kbakobu4/The-generator-of-electrical-signals-of-various-forms-on-STM8/README.md

This project was developed for the STM8S207RB controller development board, which is a microcontroller with the necessary wiring, a 12-bit SPI dac7512n/3k DAC, a matrix keyboard and a MT-12864J graphic display.
