kbakobu4/The-generator-of-electrical-signals-of-various-forms-on-STM8/Перечень элементов курсача MCU.PDF

Изм. Лист | | | Подпись | Дата
| | Разраб. | Кушков Е.О. | | | Генератор электрических сигналов разной формы Перечень элементов | Литера | Лист | Листов
Пров. | Мусоров И.С. | | | | У | | | | 1

Копировал

| Микросхемы
DD1 | STM8S207RB микроконтроллер 8-бит, 24 МГц, | 1
| 128КБ Flash, 10-бит АЦП, USB, I2C, SPI [LQFP-48]
DD2 | DAC7512N/3K ЦАП 12-бит, SPI | 1
С1…C4 | GRM21BR71E104KA01L конденсатор керамический | 4
| 100 нФ
C5 | GRM319R71E684KA01D конденсатор керамический | 1
| 680 нФ
| Конденсаторы Подп. и дата

Поз.
Обознач.
Наименование | Кол. | Примечание.

Кнопки
| 17
X3 | № докум Взам. инв. № PLS-2 штыревой разъем 1x2 контакта

ТПУ ИШНКБ
группа 1А02

Н.контр
Утв. | Мусоров И.С.
Формат А4
X1 | PLS-4 штыревой разъем 1x4 контакта | 1
SB1…SB17 | IT-1187-160GM-G кнопка тактовая Подп. и дата ФЮРА.1А0212.012 ПЭ3 | 1
| | 1
X2 | PLS-20 штыревой разъем 1x20 контактов Инв. № дубл. Разъемы Инв. № подл
| Резисторы
R1…R5 | CF-100 (С1-4) 1 Вт, 1 кОм, 5% | 5
R6 | 3296W-1-103LF (СП5-2ВБ) 0,5 Вт, 10 кОм резистор | 1
| подстроечный
