kbakobu4/The-generator-of-electrical-signals-of-various-forms-on-STM8/ПЭ Курсач MCU.xlsx

Sheet: 1_Лист
 | Поз. Обознач. |  |  | Наименование |  |  |  | Кол. |  | Примечание.
 |  |  |  | Конденсаторы
 | С1…C4 |  |  | GRM21BR71E104KA01L конденсатор керамический |  |  |  | 4
 |  |  |  | 100 нФ
 | C5 |  |  | GRM319R71E684KA01D конденсатор керамический |  |  |  | 1
 |  |  |  | 680 нФ
 |  |  |  | Микросхемы
 | DD1 |  |  | STM8S207RB микроконтроллер 8-бит, 24 МГц, |  |  |  | 1
 |  |  |  | 128КБ Flash, 10-бит АЦП, USB, I2C, SPI [LQFP-48]
 | DD2 |  |  | DAC7512N/3K ЦАП 12-бит, SPI |  |  |  | 1
 |  |  |  | Резисторы
 | R1…R5 |  |  | CF-100 (С1-4) 1 Вт, 1 кОм, 5% |  |  |  | 5
 | R6 |  |  | 3296W-1-103LF (СП5-2ВБ) 0,5 Вт, 10 кОм резистор |  |  |  | 1
Подп. и дата
 |  |  |  | подстроечный
 |  |  |  | Кнопки
 | SB1…SB17 |  |  | IT-1187-160GM-G кнопка тактовая |  |  |  | 17
Инв. № дубл.
 |  |  |  | Разъемы
 | X1 |  |  | PLS-4 штыревой разъем 1x4 контакта |  |  |  | 1
 | X2 |  |  | PLS-20 штыревой разъем 1x20 контактов |  |  |  | 1
Взам. инв. №
 | X3 |  |  | PLS-2 штыревой разъем 1x2 контакта |  |  |  | 1
Подп. и дата
 |  |  |  |  |  |  | ФЮРА.1А0212.012 ПЭ3
 | Изм. | Лист | № докум |  | Подпись | Дата
Инв. № подл | Разраб. |  | Кушков Е.О. |  |  |  | Генератор электрических сигналов разной формы |  | Литера |  |  | Лист | Листов
 | Пров. |  | Мусоров И.С. |  |  |  |  |  | У |  |  |  | 1
 |  |  |  |  |  |  |  |  | ТПУ ИШНКБ группа 1А02
 | Н.контр |  |  |  |  |  | Перечень элементов
 | Утв. |  | Мусоров И.С.
 |  |  |  |  |  |  | Копировал |  |  |  | Формат А4

Sheet: 2_Лист
 | Поз. Обознач. |  |  | Наименование |  |  |  | Кол. | Примечание.
 |  |  |  | Микросхемы цифровые
 | DD1 |  |  | STM32F103RBT6 микроконтроллер 32-Бит, |  |  |  | 1
 |  |  |  | Cortex-M3, 72МГц, 64КБ Flash, USB, CAN [LQFP-48]
 | DD2...DD5 |  |  | DS18B20 цифровой датчик температуры 1-Wire |  |  |  | 4
 | DD6 |  |  | BMP180 цифровой датчик давления I2C |  |  |  | 1
 | DD7 |  |  | HMC5883L цифровой трехосевой магнитометр I2C |  |  |  | 1
 |  |  |  | Разъемы
 | X1 |  |  | KLS2-102-5.00-03P-2S клемник винтовой 3 контакта |  |  |  | 1
 | X2 |  |  | microUSBB-5SAD12REV разъем microUSB |  |  |  | 1
 | X3…X5 |  |  | 5-146308-2 штыревой разъем 2x4 контакта |  |  |  | 3
 | XP1…XP3 |  |  | TSM-102-01-L-SV штыревой разъем 1x4 контакта |  |  |  | 3
 | XS1…XS3 |  |  | 280359-0 розетка на кабель 1х4 контакта
Подп. и дата
 |  |  |  | Резисторы
 | R1, R2 |  |  | CF-100 (С1-4) 1 Вт, 22 Ом, 5% |  |  |  | 2
 | R3 |  |  | CF-100 (С1-4) 1 Вт, 10 кОм, 5% |  |  |  | 1
 | R4, R5 |  |  | CF-100 (С1-4) 1 Вт, 100 кОм, 5% |  |  |  | 2
 | R6 |  |  | CF-100 (С1-4) 1 Вт, 10 кОм, 5% |  |  |  | 1
Инв. № дубл.
 | R7…R12 |  |  | CF-100 (С1-4) 1 Вт, 4,7 кОм, 5% |  |  |  | 6
 |  |  |  | Резонаторы
Взам. инв. №
 | ZQ1 |  |  | DT-38-32.768kHz кварцевый резонатор 32,768 кГц |  |  |  | 1
 | ZQ2 |  |  | HC-49SM кварцевый резонатор 8 МГц |  |  |  | 1
 |  |  |  | Электродвигатели
Подп. и дата
 | M1, M2 |  |  | EM64ZY15 электродвигатель 12 В 70 Вт |  |  |  | 2
 | SB1 |  |  | IT-1187-160GM-G Кнопка тактовая |  |  |  | 1
Инв. № подл
 |  |  |  |  |  |  | ФЮРА.ХХХХХХ.001 ПЭ3 |  |  |  | Лист
 |  |  |  |  |  |  |  |  |  |  | 2
 | Изм. | Лист | № докум |  | Подпись | Дата
 |  |  |  |  |  |  | Копировал |  |  | Формат А4

Sheet: 3_Лист
 | ЛИСТ РЕГИСТРАЦИИ ИЗМЕНЕНИЙ
 | Изм. |  | Намера листов (страниц) |  |  |  |  |  |  | Всего листов (страниц) в докум. | № докум. | Входящий № сопроводительного докум. и дата | Подпись | Дата
 |  |  | изменен-ных |  | заменен-ных |  | новых |  | аннули-рованных
Подп. и дата
Инв. № дубл.
Взам. инв. №
Подп. и дата
Инв. № подл
 |  |  |  |  |  |  |  |  |  |  |  |  |  | Лист
 | Изм. | Лист |  | № докум |  | Подпись |  | Дата
