kbakobu4/The-generator-of-electrical-signals-of-various-forms-on-STM8/(list of files, cad)

Other CAD files:
mcu_KP/kursovaya_rabota.stp
