kbakobu4/The-generator-of-electrical-signals-of-various-forms-on-STM8/Схема курсача MCU.PDF

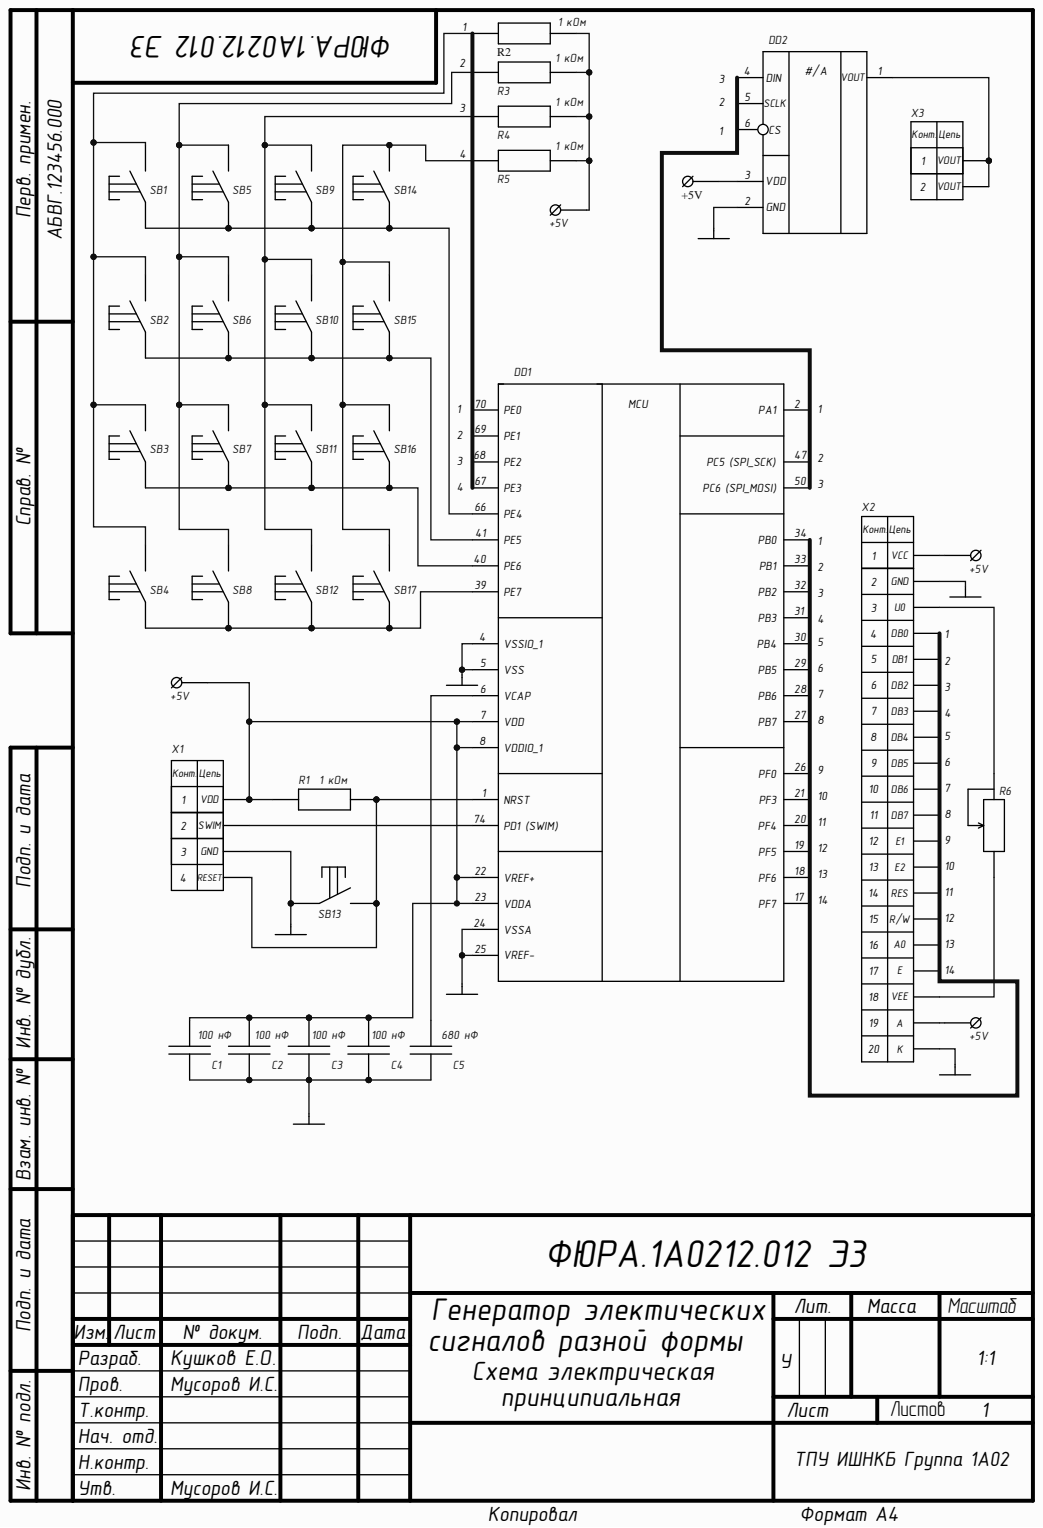
[picture p7: page 1]

SCLK 5 | X3

Конт.Цепь

1 | VOUT

2 | VOUT

1 | VDD

2 | SWIM

3 | GND

4 | RESET

18 | VEE

ФЮРА.1А0212.012 Э3

Генератор электических сигналов разной формы принципиальная | Лит. | Масса | Масштаб

Изм. | Лист | № докум. | Подп. | Дата | | У | | | 1:1 Схема электрическая
Разраб. | | Кушков Е.О.
Пров. | Мусоров И.С.
Т.контр. | | | | | Лист | Листов 1
Нач. отд. | | | | | ТПУ ИШНКБ Группа 1А02
Н.контр.
Утв. | Мусоров И.С.
